prasannaNR/Audio-Amplifier/README.md

# Audio Amplifier

Course Project for EC2.202 Electronic Workshop-II

## Repository Structure

### LTSPICE_model_files/
Contains:
- Device model files
- Technology libraries required for simulation

### LTSPICE_simulation_files/
Contains:
- LTSpice schematic files (`.asc`)
- Final integrated amplifier circuit

## Tools Used
- LTSpice
