prasannaNR/Audio-Amplifier/2024102056_2024112007_Report.pdf

# Audio Amplifier Design

Saikiran S
2024112007
saikiran.s@research.iiit.ac.in

Prasanna N R
2024102056
prasanna.r@students.iiit.ac.in

Abstract—The audio signal that is given as an input to the mic has peak-peak voltage of few milli-volts which is not sufficient to drive a speaker. This project deals with building a robust audio amplifier that amplifies the input signal and provides sufficient power to drive a speaker. This is done using an effective combination of a pre-amplifier, gain stage, band-pass filter and a power amplifier. The report includes concise calculations, simulation results of every stage.

I. INTRODUCTION

The audio amplifier processes a low-level microphone input with a peak-to-peak amplitude of approximately 10–20 mV, which is inherently susceptible to noise and interference. The first stage is a low-noise differential preamplifier that provides moderate voltage gain while offering strong common-mode noise rejection and input bias stability. This stage establishes a clean, balanced signal reference and suppresses interference picked up by the microphone and cabling.
The second stage is a common-emitter voltage amplifier with emitter degeneration, designed to provide the majority of the system’s voltage gain. Emitter degeneration improves linearity, gain stability, and reduces harmonic distortion while maintaining adequate bandwidth.
The third stage implements an active band-pass filter using a Sallen–Key topology, restricting the signal bandwidth to the audio range (20 Hz – 20 kHz). This stage suppresses out-of-band noise and prevents unwanted frequency components from propagating into the power stage.
The final stage is a power amplifier configured to deliver sufficient current and power to drive a loudspeaker, while maintaining low output impedance and minimal distortion Subsequent sections detail how each design specification is realized through circuit-level analysis and component selec-tion. In cases where a specification cannot be fully met, the underlying limitations and trade-offs are explicitly discussed, along with the corresponding design rationale.

SPECIFICATIONS

- Input Voltage to the Microphone: 10–20 mVpp
- Input Frequency Range: 20 Hz–20 kHz
- Gain: > 500 (achieved using pre-amplifier and gain stages only)
- Power Output: > 1.5W
- Load: ≈ 8 Ω

II. PRE AMPLIFIER

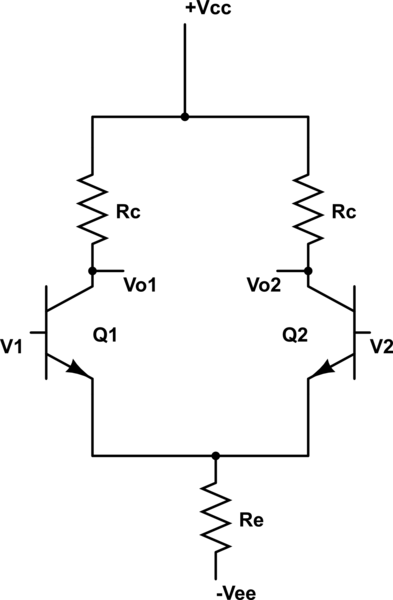
[picture p1: figure]

Fig. 1. Differential Amplifier

If Vin1 and Vin2 are the two input voltages of a differential amplifier, the output can be expressed as

Vout = A (Vin1 − Vin2),

where A is the differential gain.
In the differential amplifier, the microphone signal is applied to one base terminal of the BJT pair, while the other base is grounded. The output is taken from the collector corresponding to the opposite input terminal, enabling differential operation and improved noise rejection.
Using DC analysis, the BJTs are biased to operate in the forward-active region, and the inherent symmetry of the differential amplifier is exploited to establish stable and balanced operating points.
The design involves two unknown parameters, RC and RE. Large-signal (DC) analysis is used to determine the biasing conditions, ensuring proper operation of the transistors, while small-signal analysis is employed to achieve the required voltage gain of 20. Using these analyses, appropriate values of RC and RE are selected.

A. Large Signal Analysis
Since the large-signal input is zero, the emitter node is biased at approximately −0.7 V to maintain the BJTs in forward-active mode, resulting in a collector current IC = 5 mA. With β ≈ 200, the emitter current is approximately equal to the collector current, i.e., IE ≈ IC . By symmetry, the total current flowing through the emitter resistor is 2IC = 10 mA. Hence,

RE =

VE − VEE
10 mA

=

4.3
10 mA

≈ 430 Ω.

. The transconductance of the BJT is given by

gm =

IC
VT

For IC = 5 mA and VT ≈ 26 mV,

gm =

5 × 10⁻³
26 × 10⁻³

≈ 0.192 S.

The small-signal base–emitter resistance is

rπ =

β
gm

,

where β = 200. Hence,

rπ =

200
0.192

≈ 1.04 kΩ.

B. Small Signal Analysis

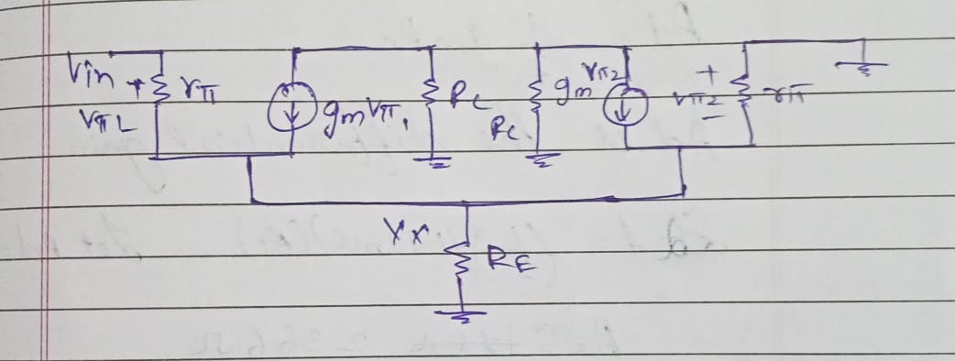
[picture p2: figure]

Fig. 2. Pre amp small signal

The small-signal node equation at the emitter node Vx is

Vx

1
RE

+

1
rπ
=

Vin − Vx
rπ

+ gmVin − 2gmVx.

Expanding and rearranging the terms,

Vx

1
RE

+

2
rπ

+ 2gm

= Vin
1
rπ

+ gm

Solving for Vx,

Vx = Vin

1
rπ

+ gm

1
RE

+

2
rπ

+ 2gm

Hence, the emitter node gain is given by

Vx

Vin

=

1
rπ

+ gm

1
RE

+

2
rπ

+ 2gm

The output voltage is taken at the collector and is given by

Vout = gmRC Vx.

Substituting the expression for Vx,

Vout = gmRC Vin

1
rπ

+ gm

1
RE

+

2
rπ

+ 2gm

Hence, the overall small-signal voltage gain is

Vout

Vin

= gmRC

1
rπ

+ gm

1
RE

+

2
rπ

+ 2gm

The differential gain after simplifying the above expression is given by

Ad =

1
2

gmRC .

We wanted a gain of 16.4, thus we calculate Rc Rearranging,

RC =

2Ad
gm

Substituting Ad = 16.4 and gm = 192 mS, Thus, a standard resistor value of

RC = 175 Ω

is chosen, resulting in a gain close to the desired specification. To determine the common-mode gain, the same input voltage is applied to both base terminals of the differential pair. Applying KCL at the emitter node gives

2(Vin − Vx)
rπ

+ 2gm(Vin − Vx) = Vx
RE

Solving for Vx,

Vx = Vin

2

1
rπ

+ gm

1
RE

+ 2
1
rπ

+ gm

The output voltage is given by

Vout = −gmRC (Vin − Vx).

Hence, the common-mode gain is

Ac =

Vout

Vin

= −gmRC

1 −

2

1
rπ

+ gm

1
RE

+ 2
1
rπ

+ gm

Under the assumption that gmrπ ≫ 1 and RE is sufficiently large, the above expression simplifies to

Ac ≈ −

RC
2RE

C. CMRR calculations
Using Ad | ≈
1/2 gmRC and Ac | ≈ − RC
2RE

, the ratio of
differential gain to common-mode gain is

Ad
Ac

= gmRE.

The common-mode rejection ratio is given by CMRR = 20 log10
Ad
Ac

With Ad
Ac

= 83,

CMRR = 20 log10(83) ≈ 20 × 1.919 ≈ 38.4 dB.

D. Output Resistance Calculation

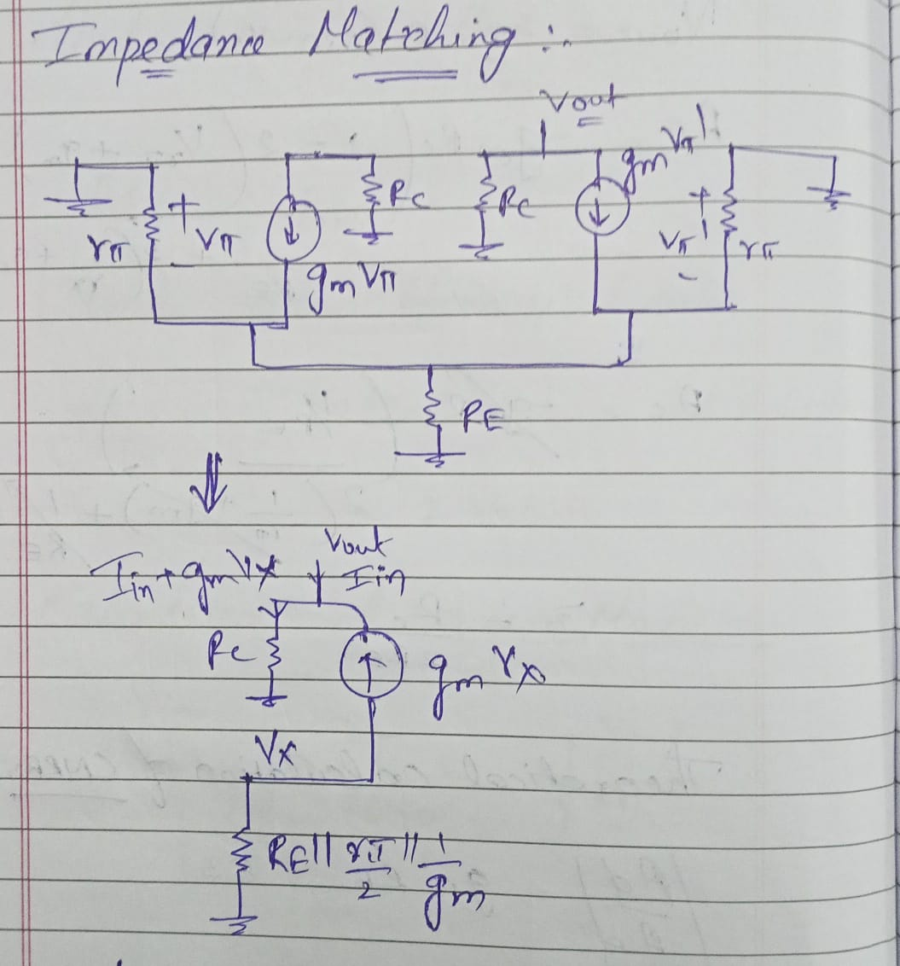
[picture p3: figure]

Fig. 3. Differential Amplifier

To determine the output resistance, the input is set to zero and a test current Iin is applied at the output node.
From small-signal analysis,

Vx

RE ∥

rπ
2

∥

1
gm

= −gmVx

This implies

Vx = 0

Hence, the output voltage becomes

Vout = IinRC

Therefore,

Vout

Iin

= RC

Rout = RC

Substituting the calculated value of RC ,

Rout = 236.6 Ω

Thus, to avoid attenuation of the signal due to loading effects, the input impedance of the gain stage must be significantly larger than the output resistance of the previous stage.
As a standard design rule,

Rin,gain ≥ 10 Rout

This ensures minimal voltage division between the stages and preserves the intended signal amplitude.

III. GAIN STAGE
The gain stage is a common-emitter amplifier with emitter degeneration.

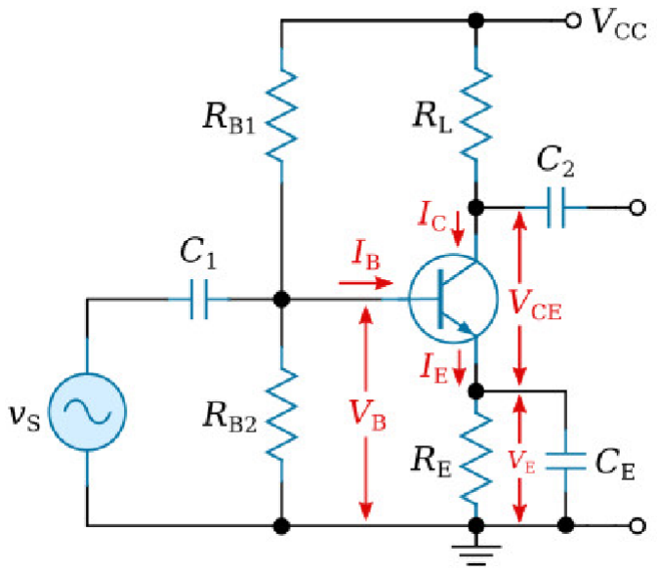
[picture p4: figure]

Fig. 4. Gain stage

A. Large Signal Analysis
For designing the second stage, the following assumptions are made:
1) Av = 22.5
2) VBE = 0.65 V
3) VO(DC) = 0.9 V
We choose these three assumptions for designing as :
The output should have the maximum voltage swing. Clipping was observed in simulations when VO(DC) was taken to be 0.65-0.7 (Theoretically this provides the maximum swing while maintaining the BJT in forward active mode). Thus a higher VO(DC) was chosen and calculations done based on this.
DC and Small-Signal Parameters:

IC = ISe

VBE
VT = 0.72 mA

RC =

VCC − VO
IC

=

5 − 0.9
0.72 mA

≈ 5.7 kΩ

gm =

IC
VT

=

0.72 mA
26 mV

= 27.6 mS

rπ =

β
gm

=

200
27.6 mS

≈ 7.24 kΩ

The base voltage is

VB = VBE + VE = 0.65 + (−4.86) = −4.2 V

Applying KVL across the bias divider from +5 V to −5 V,

5 + 4.2

RB1

=

0.8

RB2

RB1

RB2

= 11.5

To ensure stiff biasing, the divider current is chosen as

Idiv = 10IB = 10 × 3.6 µA = 36 µA

Thus,

RB1 + RB2 =

10
36 µA

≈ 138.8 kΩ

Using
RB1 = 11.5RB2

11.5RB2 + RB2 = 138.8 kΩ

12.5RB2 = 138.8 kΩ

RB2 ≈ 11.1 kΩ

RB1 ≈ 127.7 kΩ

RB1 ≈ 128 kΩ, RB2 ≈ 11 kΩ

B. Small Signal Calculations

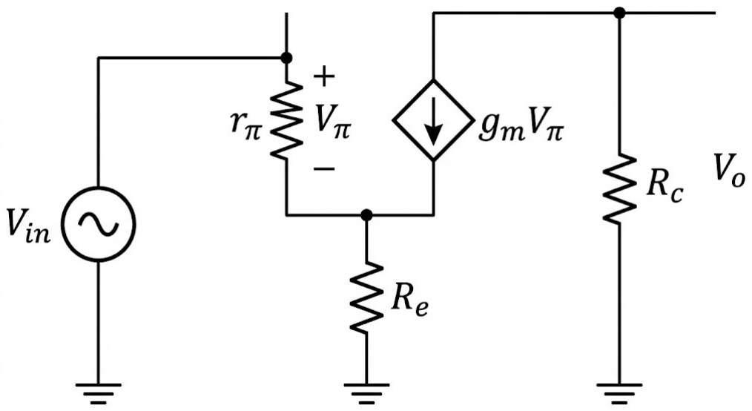
[picture p5: figure]

Fig. 5. Small Model

Voltage Gain Derivation: Applying KCL at node Vx,

Vx
RE

=

Vin − Vx
rπ

+ gm(Vin − Vx)

Rearranging,

Vx
RE

=

1
rπ

+ gm

(Vin − Vx)

Vx = RE

1
rπ

+ gm

(Vin − Vx)

Vx

1 + RE
1
rπ

+ gm

= RE

1
rπ

+ gm

Vin

Vx

Vin

=

RE

1
rπ

+ gm

1 + RE

1
rπ

+ gm

The output voltage is

Vo = −gmRC (Vin − Vx)

Substituting,

Vo

Vin

= −gmRC

1

1 + RE

1
rπ

+ gm

If 1
rπ

≪ gm, then

Av =

Vo

Vin

≈ −

gmRC
1 + gmRE

Since the first stage provides a gain of approximately 16.5, the second stage is designed to provide

Av = −22.5

Using the previously derived expression,

Av ≈ −

gmRC
1 + gmRE

Substituting gm = 27.6 mS and RC = 5.7 kΩ,

22.5 =

(27.6 × 10⁻³
)(5.7 × 10³
)
1 + (27.6 × 10⁻³)RE

22.5 =

157.32
1 + 0.0276RE

Solving,

1 + 0.0276RE =

157.32
22.5

1 + 0.0276RE ≈ 6.99

0.0276RE ≈ 5.99

RE ≈ 190 Ω

RE = 190 Ω

Verification of Forward-Active Operation: For a BJT to operate in the forward-active region,

VBE > 0 and VBC < 0

The collector voltage is

VC = VCC − IC RC

VC = 5 − (0.72 mA)(5.7 kΩ)

VC = 5 − 4.10 = 0.9 V

The base voltage is

VB = −4.2 V

Thus,

VBC = VB − VC

VBC = −4.2 − 0.9

VBC = −5.1 V

Since

VBC < 0

the collector–base junction is reverse biased.

Hence, the BJT operates in the forward-active region.

C. Rin derivation

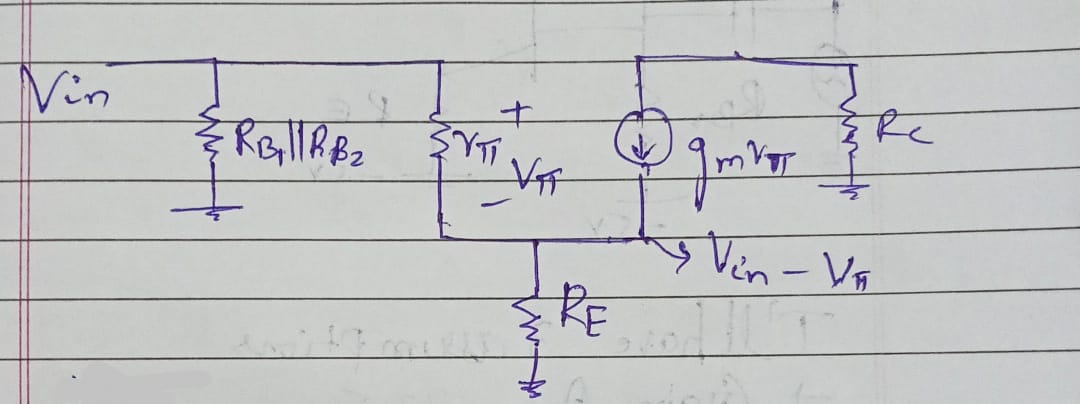
[picture p6: figure]

Fig. 6. Small Model

Applying KCL at the base–emitter small-signal model,

Vπ
rπ

+ gmVπ =

Vin − Vπ
RE

Rearranging,

Vπ

1
rπ

+ gm +

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
+ gm +

1
RE

The total input current is

Iin =

Vin

RB1 ∥ RB2

+

Vπ
rπ

Substituting for Vπ,

Iin =

Vin

RB1 ∥ RB2

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
+ gm +

1
RE

Hence,

Rin =

Vin

Iin

=

1

RB1 ∥ RB2

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
+ gm +

1
RE

−1

Substituting

rπ = 7.24 kΩ, | gm = 27.6 mS, | RE = 190 Ω, | RB1 ∥ RB2 ≈ 10.1 kΩ

Rin ≈ 8.26 kΩ

Loading Verification: From the previous stage, the output resistance was

Rout = 236.6 Ω

To avoid attenuation due to loading,

Rin,min = 10 Rout = 10 × 236.6 = 2.366 kΩ

Since the calculated input resistance of the gain stage is

Rin = 8.26 kΩ

Rin > Rin,min

Thus, the loading effect is negligible and the inter-stage signal attenuation is avoided.

IV. FILTER

The filter stage is implemented using cascaded Sallen– Key high-pass and low-pass sections to realize a band-pass response over 20 Hz – 20 kHz.
A standard second-order filter provides a roll-off of 20 dB/decade. Since both sections are second-order, cascading them results in a fourth-order band-pass filter.
Hence, the overall roll off outside the passband is 40 dB/decade, providing sharper cutoff and improved noise rejection.

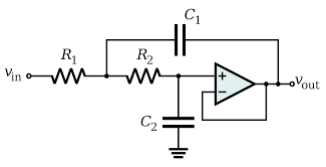
[picture p7: figure]

Fig. 7. Low pass filter

Fig. 8. High pass Filter

A. Low-Pass Filter Design
Let Vx(s) be the intermediate node voltage between R1 and R2.
Applying KCL at Vx(s),

Vx − Vin
R1

+

Vx − Vo
R2

+

Vx − Vo
XC1

= 0

The output is given by

Vo(s) = XC2
XC2 + R2

Vx(s)

After simplification, the transfer function becomes

H(s) = Vo(s)
Vin(s)

=

1
1 + sC2(R1 + R2) + s

2C1C2R1R2

A standard second-order low-pass filter is of the form

H(s) = | ω

2
0
s

2 + 2αs + ω

2
0
where

ω0 =

1
√
R1R2C1C2

, 2α =

R1 + R2
R1R2C1

Q =

ω0
2α
Let

R1 = mR, R2 =

R
m
, | C1 = nC, | C2 =

C
n
Then

Q =

| mn
m² + 1
For

Q =

1
2

, m = n = 1

Choosing

f0 = 50 kHz

R1 =

| 1
2πf0C1
Let

C1 = C2 = 0.1 nF

R1 = R2 =

1
2π(50 × 10³)(0.1 × 10⁻⁹)

≈ 27 kΩ

B. High-Pass Filter Design
Let Vx(s) be the node voltage between C1 and C2. Applying KCL at Vx(s),

Vx − Vin
XC1

+

Vx − Vout
R1

+

Vx − Vout
XC2

= 0

The output voltage is

Vout(s) = Vx(s)

R2
R2 + XC2

After simplification, the transfer function becomes

H(s) = | s

2
s

2 +

| ω0 Q
s + ω

2
0
where

ω0 =

1
√
R1R2C1C2

,

ω0
Q

=

C1 + C2
R2C1C2

Let

R1 = mR, R2 =

R
m

, C1 =

C
n

, C2 = nC

Then

Q =

n
m(n² + 1)

Choosing

m = 0.1, Q = 0.7

0.0707n

2 − 0.1n + 0.0707 = 0

n ≈ 14.07 or n ≈ 0.07

The cutoff frequency is

f0 =

1
2πRC
We will have
f0 = 10Hz

Let

R1 = 16 kΩ, R2 = 1.6 MΩ

f0 =

1
2πC(16 × 10³)

Choosing

C = 0.1 µF

C1 =

C
n

= 7.2 nF, C2 = nC = 1.4 µF

V. POWER AMPLIFIER

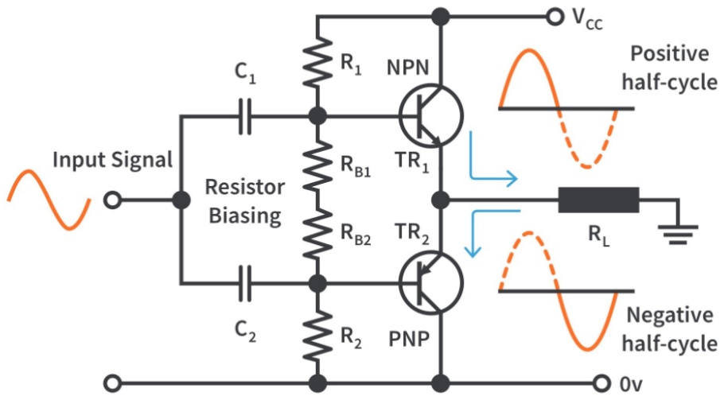
[picture p8: figure]

Fig. 9. Class AB Power-Amp

We design the power amp such that both the NPN and the PNP power transistors are biased near cutoff. On doing so the NPN allows the positive half cycle of the input waveform (as the PNP will be in cutoff) and the PNP allows the negative half cycle of the input waveform(as the NPN will be in cutoff) D

A. Biasing and Small-Signal Analysis of Output Stage
By symmetry,

R1 = R2 = R = 1kΩ

The diodes are designed to have a drop of

VBE = 0.65 V

with non-ideality factor

η = 1.75

and

IS = 2.52 nA

Using the diode equation,

IC = ISe

VBE
ηVT = 3.5 mA

The base current is

IB = 0.6 mA

Hence, the current through the bias resistor is

IR = 4.1 mA

R =

5 − 0.65
4.1 mA
= | 4.35
4.1 mA
| ≈ 1.03 kΩ

The transconductance is

gm =

dIC dVBE | ≈ IC
| VT
Since

Vout = IERL ≈ IC RL

and

Vin − VBE = Vout

we get

Vout = Vin −

IC
gm
Noting that

1
gm

= re

Vout = Vin − IC re

IC RL = Vin − IC re

Vin = IC (RL + re)

Vout

Vin

=

RL
RL + re
Since typically

RL ≫ re

Vout

Vin

≈

RL
RL

= 1

Thus, the voltage gain of the emitter follower output stage is approximately unity.The output of the power amplifier for an 8Ω speaker is :

PAC =

V

2
out−rms
RL

≈

8.8
2

∗

8.8
2
2 ∗ 8

≈ 1.21W

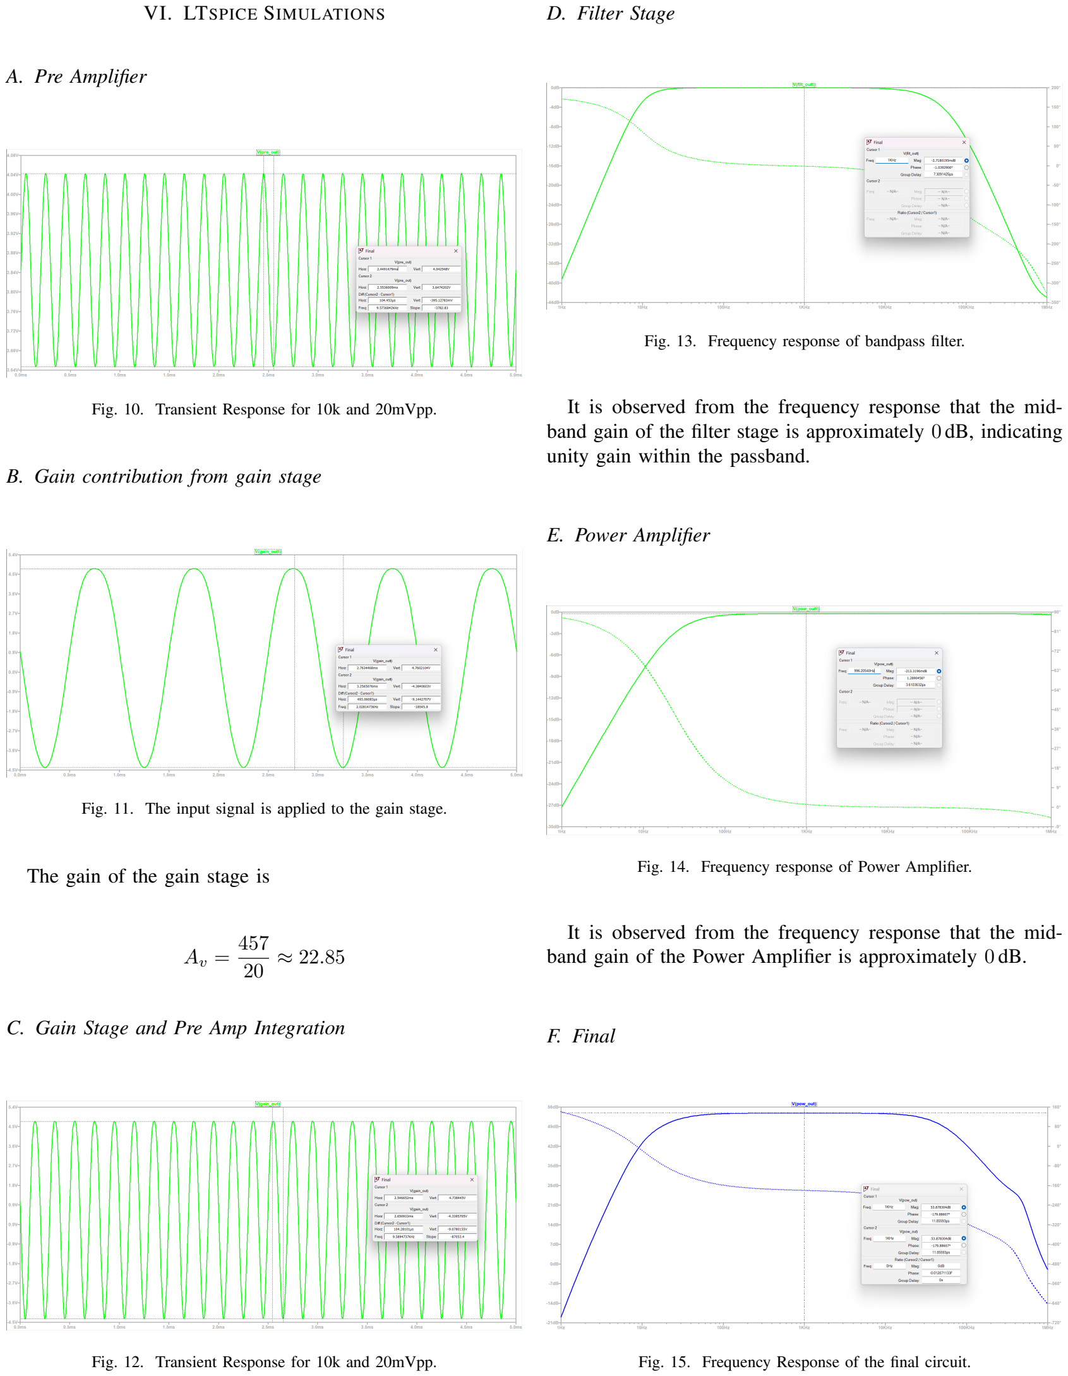
[picture p9: page 8]

VI. LTSPICE SIMULATIONS

A. Pre Amplifier

Fig. 10. Transient Response for 10k and 20mVpp.

B. Gain contribution from gain stage

Fig. 11. The input signal is applied to the gain stage.

The gain of the gain stage is

Av =

457
20

≈ 22.85

C. Gain Stage and Pre Amp Integration

Fig. 12. Transient Response for 10k and 20mVpp.

D. Filter Stage

Fig. 13. Frequency response of bandpass filter.

It is observed from the frequency response that the mid-band gain of the filter stage is approximately 0 dB, indicating unity gain within the passband.

E. Power Amplifier

Fig. 14. Frequency response of Power Amplifier.

It is observed from the frequency response that the mid-band gain of the Power Amplifier is approximately 0 dB.

F. Final

Fig. 15. Frequency Response of the final circuit.

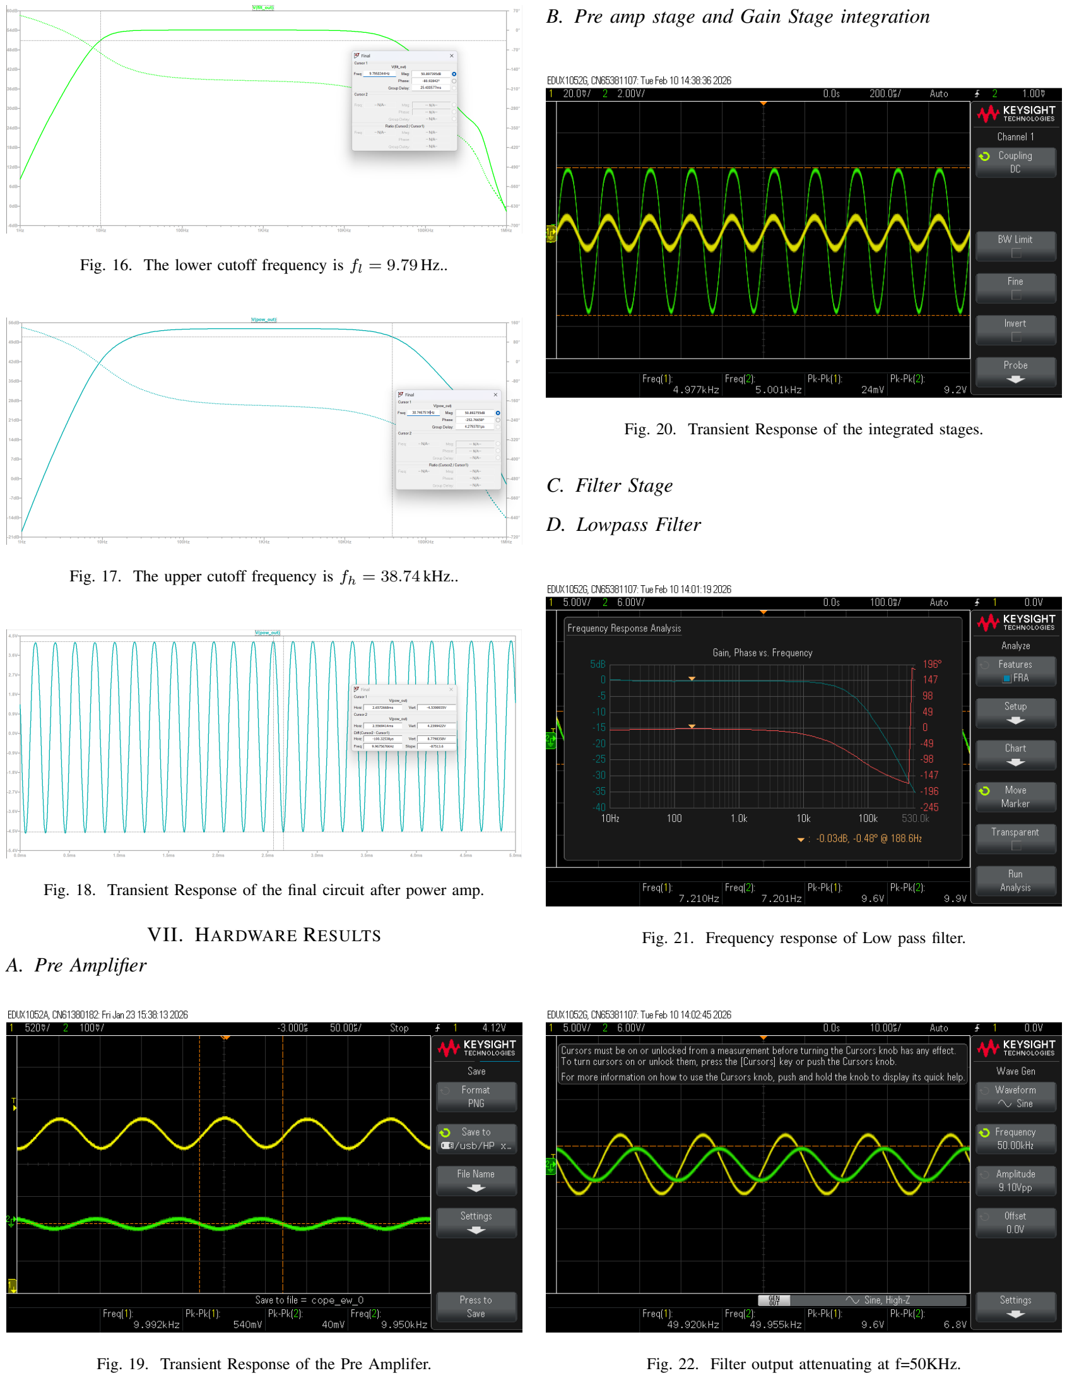
[picture p10: page 9]

Fig. 16. The lower cutoff frequency is fl = 9.79 Hz..

Fig. 17. The upper cutoff frequency is fh = 38.74 kHz..

Fig. 18. Transient Response of the final circuit after power amp.

VII. HARDWARE RESULTS
A. Pre Amplifier

Fig. 19. Transient Response of the Pre Amplifer.

B. Pre amp stage and Gain Stage integration

Fig. 20. Transient Response of the integrated stages.

C. Filter Stage
D. Lowpass Filter

Fig. 21. Frequency response of Low pass filter.

Fig. 22. Filter output attenuating at f=50KHz.

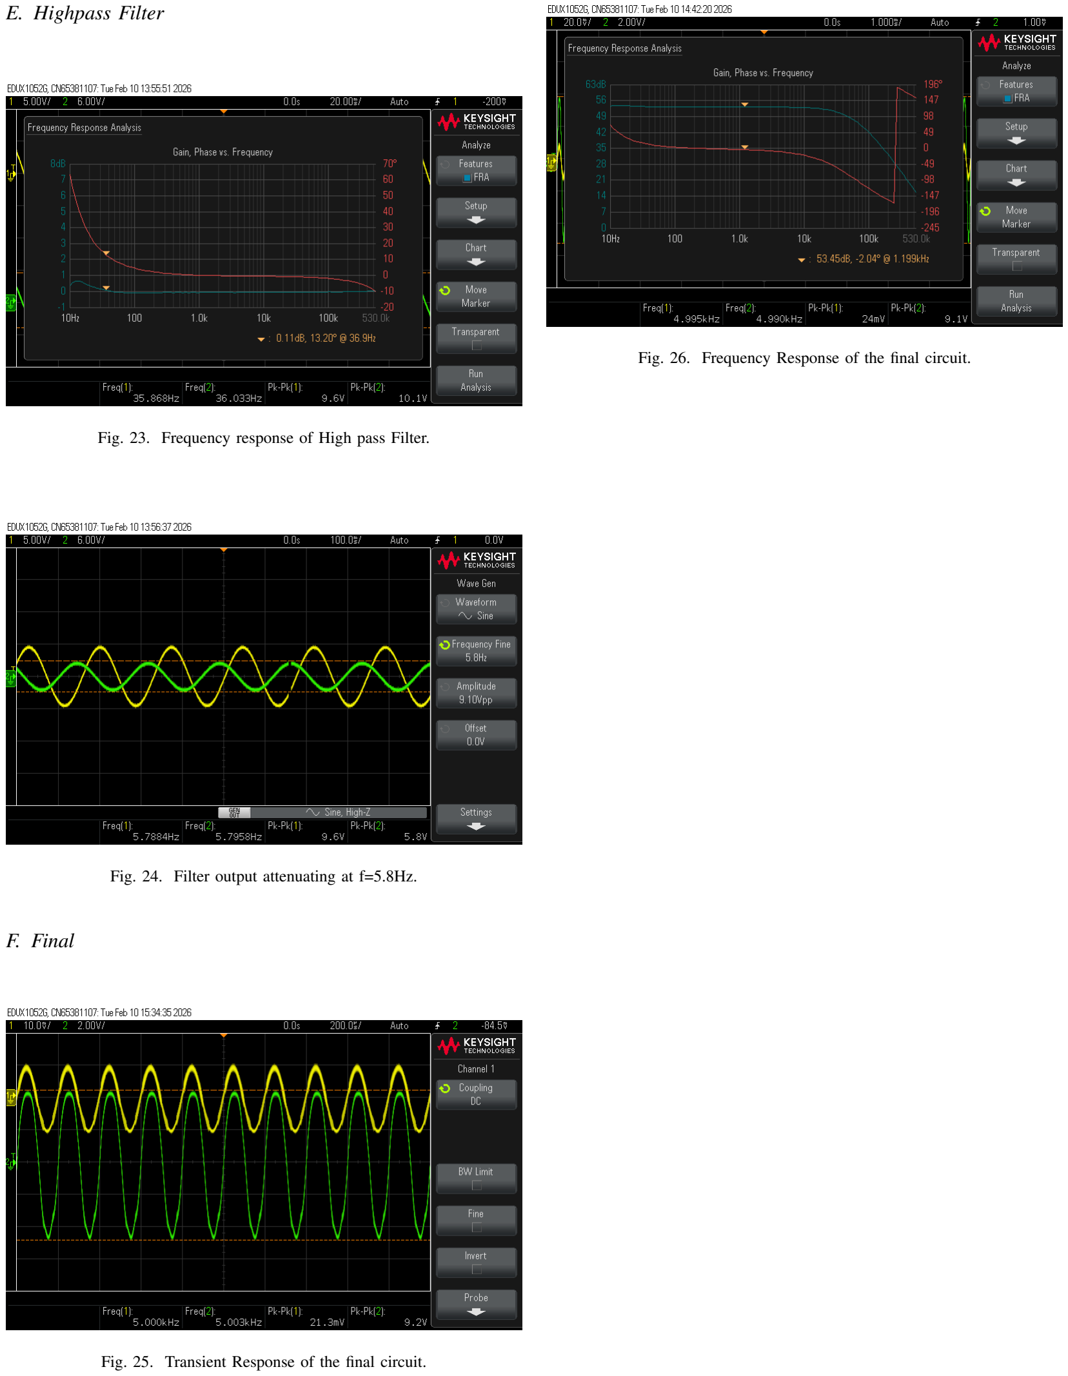
[picture p11: page 10]

E. Highpass Filter

Fig. 23. Frequency response of High pass Filter.

Fig. 24. Filter output attenuating at f=5.8Hz.

F. Final

Fig. 25. Transient Response of the final circuit.

Fig. 26. Frequency Response of the final circuit.

VIII. CIRCUIT PARAMETERS

A. CMRR

The differential gain is measured as

Ad = 17

The common-mode gain is obtained by applying the same input to both terminals of the differential pair and measuring the output:

Ac =

5.3
20

= 0.265

The Common-Mode Rejection Ratio (CMRR) is then calculated as
CMRR = 20 log10
17

0.265

CMRR ≈ 36.1 dB

B. Total Harmonic Distortion (THD)

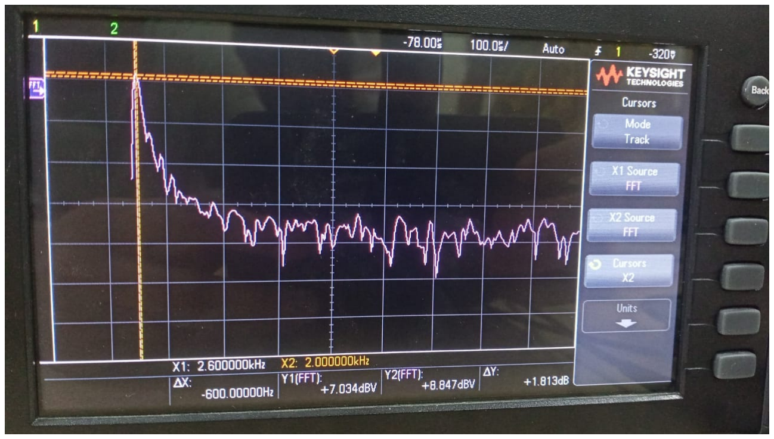
[picture p12: figure]

Fig. 27. FFT plot for f=2KHz.

The total harmonic distortion is calculated using

T HD =

vuutX∞

n=2

V

2
n,RMS

Vf,RMS

The worst-case distortion values observed were:

T HD = 8.09% at 10 mV, 20 kHz

T HD = 9.08% at 10 mV, 20 Hz

The best-case distortion measured was

T HD = 2.56%

C. Slew Rate

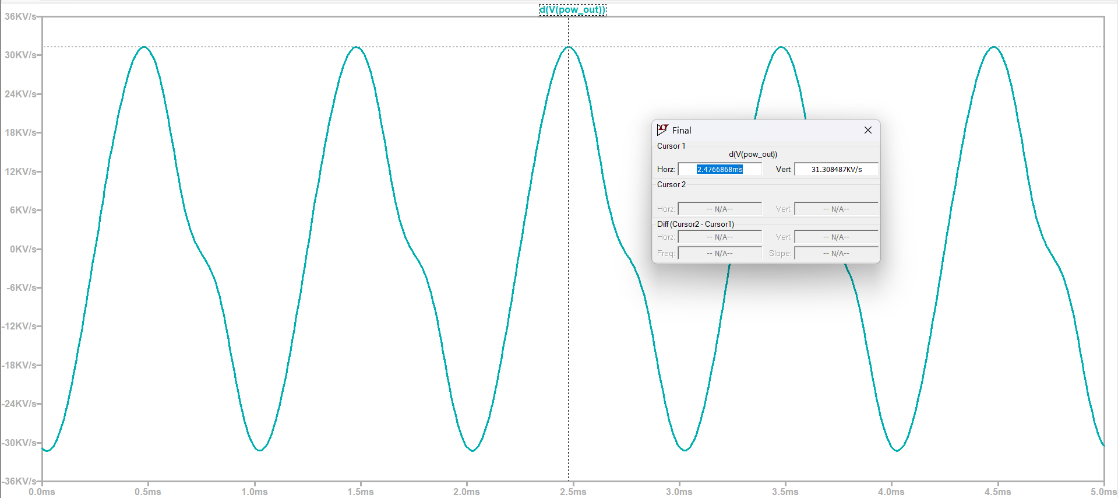
[picture p13: figure]

Fig. 28. Measuring slew rate of the circuit.

The slew rate turns out to be 31.3KV/s. We observe a linear rise in voltage output due to the slew rate of the op-amp not being able to track the input voltage accurately. Hence while implementing the hardware we choose an op-amp with a better slew rate - TL081.

D. AC Power Calculation
The AC output power delivered to the load is given by

PAC =

V

2
RMS
Rload

=

V

2
peak
2Rload
Substituting,

PAC =

4.6

2
2 × 10

PAC =

21.16
20

PAC ≈ 1.06 W

IX. CONCLUSION
The designed audio amplifier achieves a gain of over 450 with acceptable distortion and bandwidth. We have made key improvements such as implementing higher-order filters that has sharper Q-factor and higher slope. However few more improvements Thermal compensation techniques through Thermal compensation techniques in the Class-AB output stage to reduce bias drift and crossover distortion, Integration of negative feedback across stages to reduce THD and improve linearity and others.

REFERENCES

[1] Wikipedia, “Sallen–Key Topology.”
[2] IIT Bombay, “Differential Amplifier Notes,” Available: https://www.ee.iitb.ac.in/∼sequel/ee230/mbpth diff 1.pdf
[3] B. Razavi, “Common-Emitter (CE) Amplifier,” YouTube Lecture.
[4] J. Fiore, “Electronics Lecture Series,” YouTube.
