prasannaNR/Audio-Amplifier/LTSPICE_simulation_files/Filter Stage.asc

C1: cap; 1.5µ
C2: cap; 7.2n
C3: cap; 0.1n
C4: cap; 0.1n
R1: res; 16k
R2: res; 1.6Meg
R3: res; 24k
R4: res; 24k
U1: UA741
U2: UA741
V1: voltage; 12
V2: voltage; -12
V3: voltage; SINE(1 1 1); AC 1
Named nets: 0, VCC, VSS
.ac dec 100 1 1Meg
