prasannaNR/Audio-Amplifier/LTSPICE_simulation_files/Final.asc

C1: cap; 10µ
C2: cap; 10µ
C4: cap; 10µ
C5: cap; 0.1n
C6: cap; 0.1n
C7: cap; 1.5µ
C8: cap; 7.2n
D1: diode; 1N4148
D2: diode; 1N4148
Q1: npn; 2N2222
Q2: npn; 2N2222
Q3: npn; 2N2222
Q4: npn; QTIP31A
Q5: pnp; QTIP32A
R1: res; 180
R2: res; 124k
R3: res; 11k
R4: res; 1k
R5: res; 1k
R6: res; 24k
R7: res; 24k
R8: res; 16k
R9: res; 1.6Meg
RC1: res; 232
RC2: res; 232
RE1: res; 430
RL1: res; 5.5k
RL2: res; 8
U2: UA741
U4: UA741
V1: voltage; SINE(0 10m 10k); AC 1
V2: voltage; 5
V3: voltage; -5
V4: voltage; 12
V5: voltage; -12
Named nets: 0, VCC, VSS, 12, -12, Gain_Out, Pre_Out, filt_Out, pow_Out
.MODEL Qtip31a npn
+IS=1e-09 BF=3656.16 NF=1.23899 VAF=10
+IKF=0.0333653 ISE=1e-08 NE=2.29374 BR=0.1
+NR=1.5 VAR=100 IKR=0.333653 ISC=1e-08
+NC=1.75728 RB=6.15083 IRB=100 RBM=0.00113049
+RE=0.0001 RC=0.0491489 XTB=50 XTI=1
+EG=1.05 CJE=3.26475e-10 VJE=0.446174 MJE=0.464221
+TF=2.06218e-09 XTF=15.0842 VTF=25.7317 ITF=0.001
+CJC=3.07593e-10 VJC=0.775484 MJC=0.476498 XCJC=0.750493
+FC=0.796407 CJS=0 VJS=0.75 MJS=0.5
+TR=9.57121e-06 PTF=0 KF=0 AF=1
* Model generated on Feb  8, 2004
* Model format: PSpice
.tran 0 10m 5m
.four 10k 100 V(pow_out)
.ac dec 100 1 1Meg
Pre-Amp Stage
Gain Stage
Filter Stage (Sallen Key Filter)
Class AB Power Amplifier
.MODEL Qtip32a pnp
+IS=1e-09 BF=134.366 NF=1.29961 VAF=10
+IKF=0.742988 ISE=1e-16 NE=1.40014 BR=0.1
+NR=1.46599 VAR=100 IKR=3.21978 ISC=1e-16
+NC=2.71657 RB=7.44433 IRB=2.41268 RBM=0.218936
+RE=0.0152284 RC=0.0761421 XTB=0.1 XTI=1
+EG=1.05 CJE=3.26474e-10 VJE=0.446178 MJE=0.464223
+TF=1e-08 XTF=3.50642 VTF=8.2848 ITF=0.0305862
+CJC=3.07595e-10 VJC=0.77548 MJC=0.476497 XCJC=0.799334
+FC=0.8 CJS=0 VJS=0.75 MJS=0.5
+TR=9.57121e-06 PTF=0 KF=0 AF=1
* Model generated on Feb  8, 2004
* Model format: PSpice
