prasannaNR/Audio-Amplifier/LTSPICE_simulation_files/Gain stage.asc

C1: cap; 10µ
C2: cap; 0.1µ
Q1: npn; 2N2222
R1: res; 190
R3: res; 123k
R4: res; 11k
RL: res; 6k
V1: voltage; SINE(0 166m 20k)
V2: voltage; 5
V3: voltage; -5
Named nets: 0, VCC, VSS
.tran 10m
