prasannaNR/Audio-Amplifier/LTSPICE_simulation_files/Power Amplifier.asc

C1: cap; 22µ
C2: cap; 22µ
D1: diode; 1N4148
D2: diode; 1N4148
Q1: npn; QTIP31A
Q2: pnp; QTIP32A
R1: res; 1k
R2: res; 1k
RL: res; 8
V1: voltage; SINE(0 4.3 10K)
V2: voltage; 5
V3: voltage; -5
Named nets: VCC, VSS, 0
.include "LTSPICE_model_files\\tip31a.lib"
.include "LTSPICE_model_files\\tip32a.lib"
.tran 10m
