prasannaNR/Audio-Amplifier/LTSPICE_simulation_files/Pre-Amp.asc

Q1: npn; 2N2222
Q2: npn; 2N2222
RC1: res; 190
RC2: res; 190
RE: res; 430
V2: voltage; SINE(0 10m 20k)
VCC: voltage; 5
VSS: voltage; -5
Named nets: VCC, VSS, 0
.tran 10m
